m-elias/AgOpenGPS_Boards/Misc/Schematics/steer.png

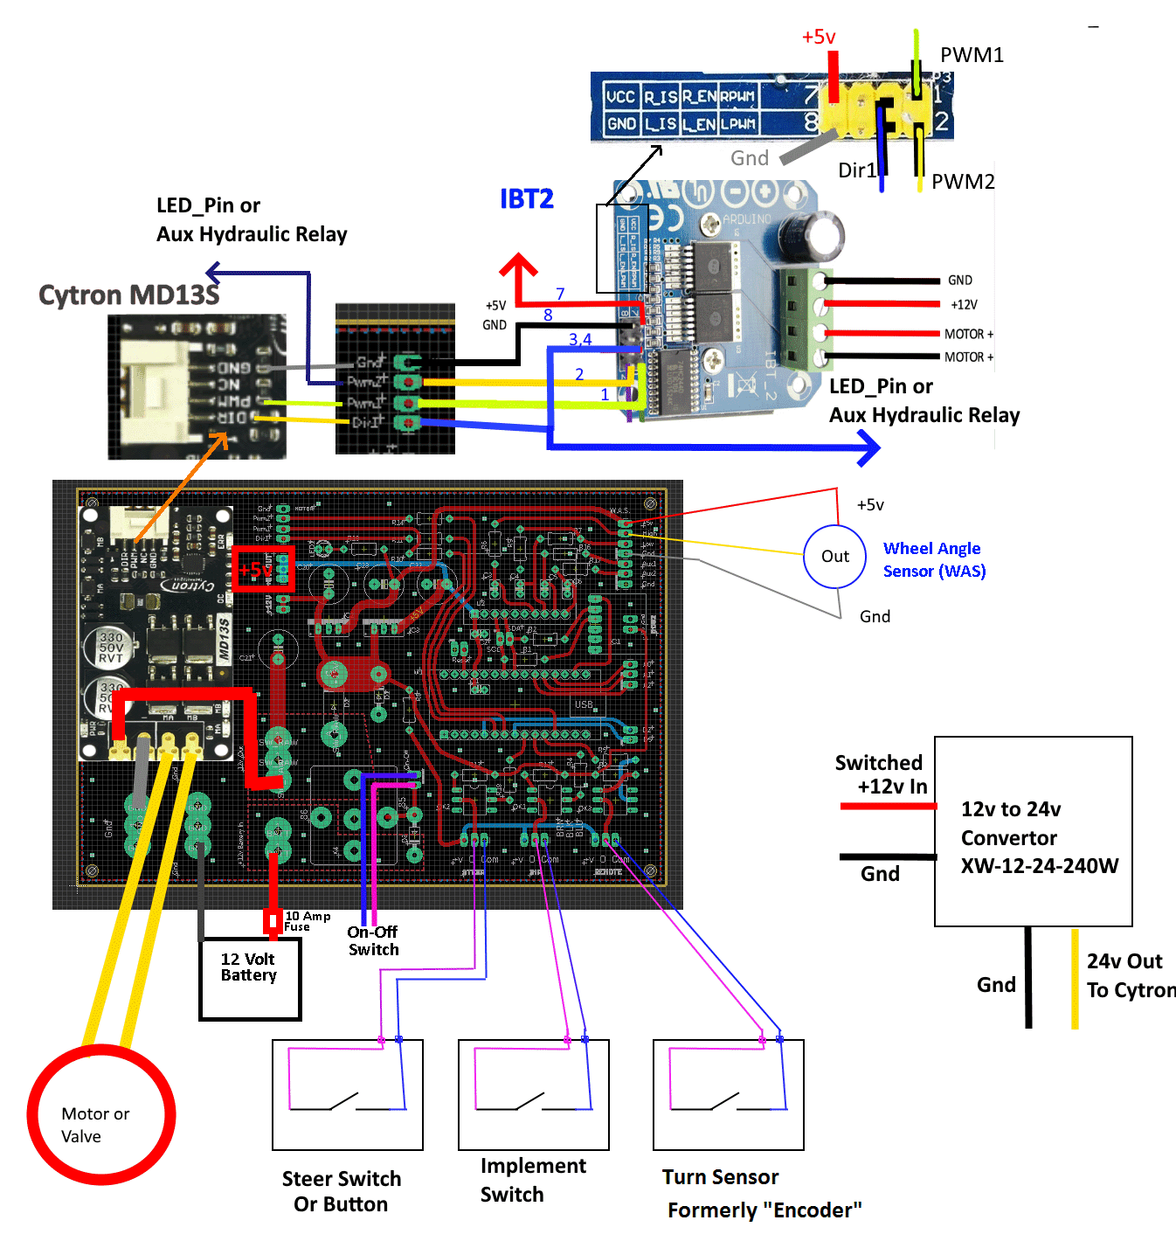
Misc/Schematics/steer.png
