m-elias/AgOpenGPS_Boards/TeensyModules/4.1 STD/MISC/3d TOP.png

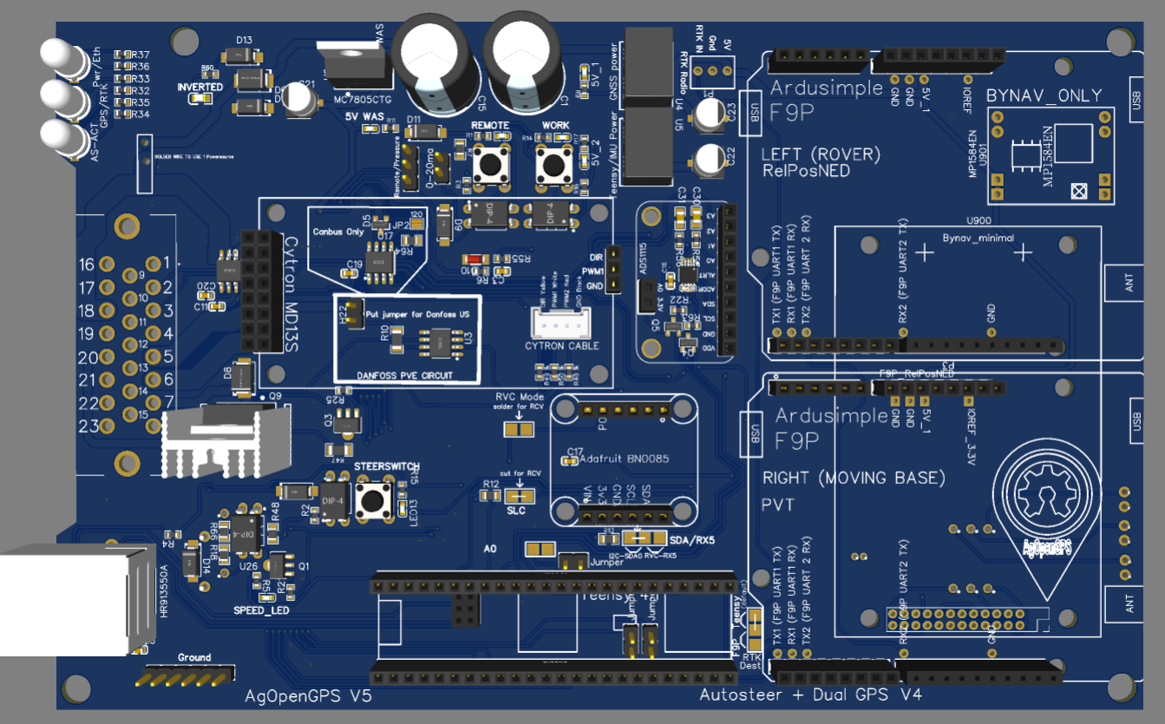
TeensyModules/4.1 STD/MISC/3d TOP.png
