m-elias/AgOpenGPS_Boards/TeensyModules/4.1 STD/Schematic_AiO V4.1 STD_RELEASE_230619/Schematic_AiO V4.1 Standard_2023-06-19_main-combined.pdf

## Power Input/Converters

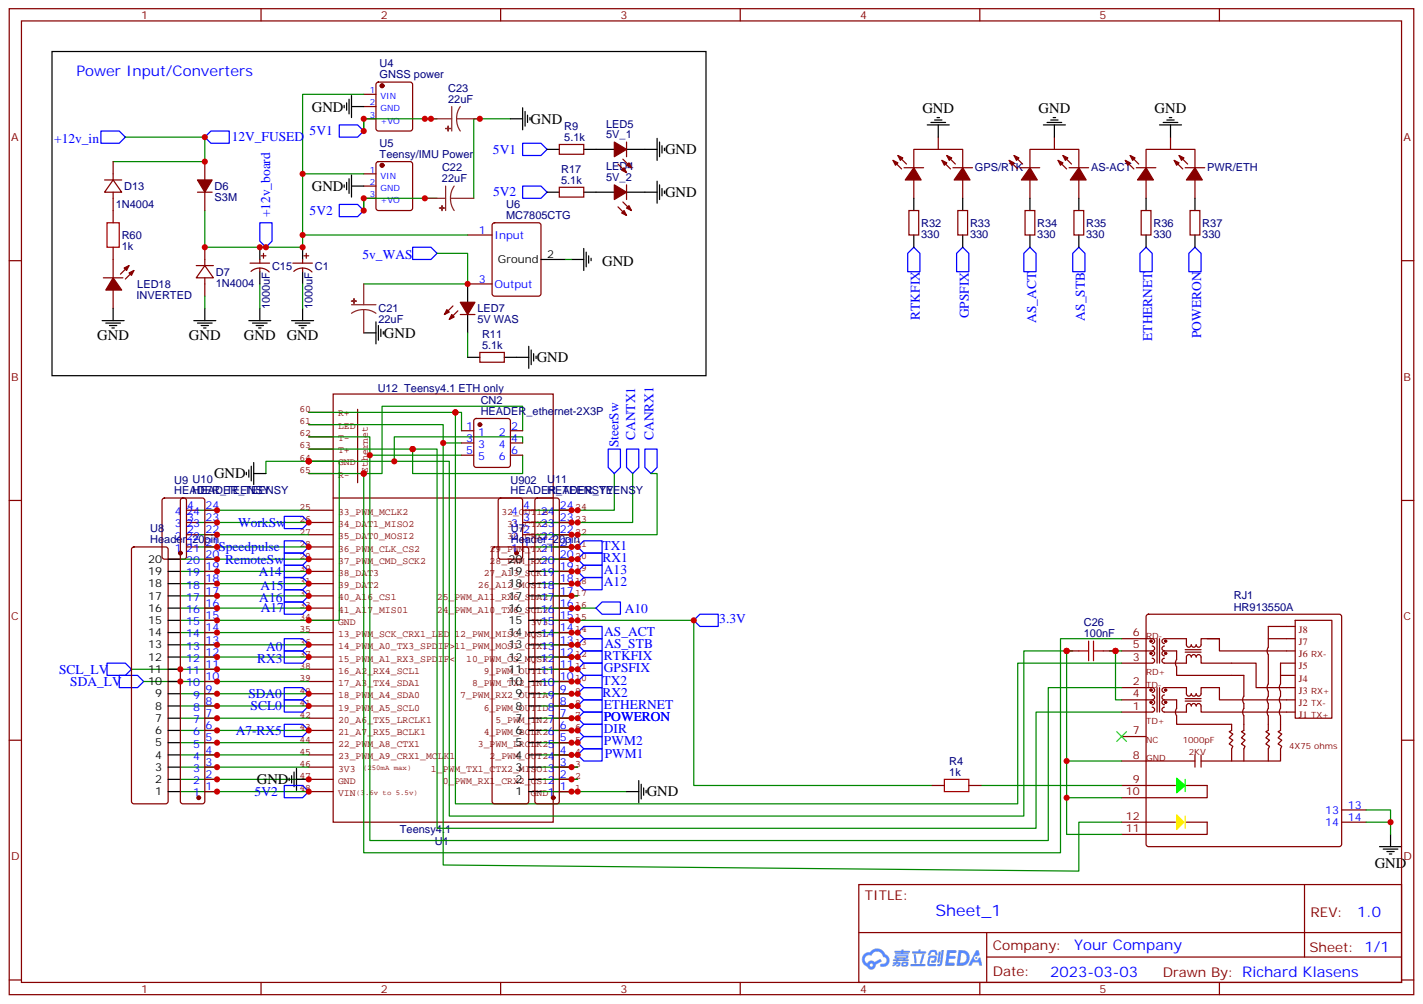
[picture p4: page 1]

Drawn By: Richard Klasens

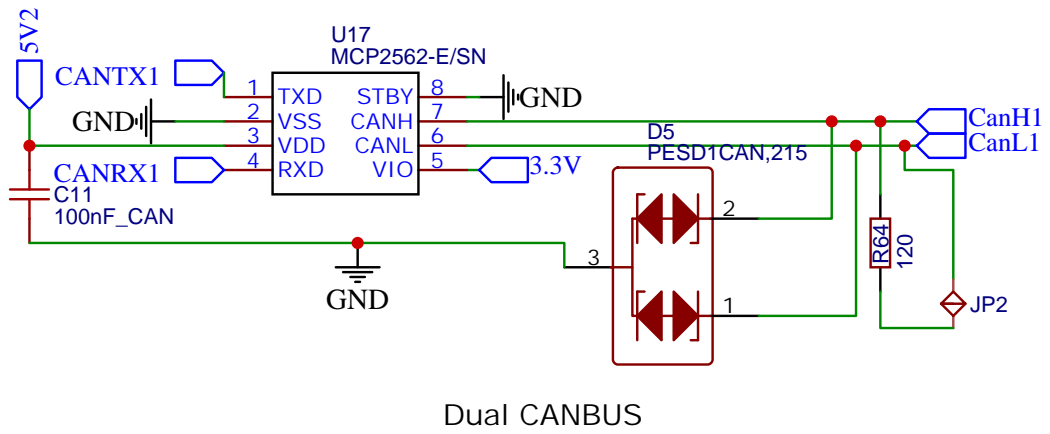
[picture p5: page 2]

## Main Connectors, just pick the one you want

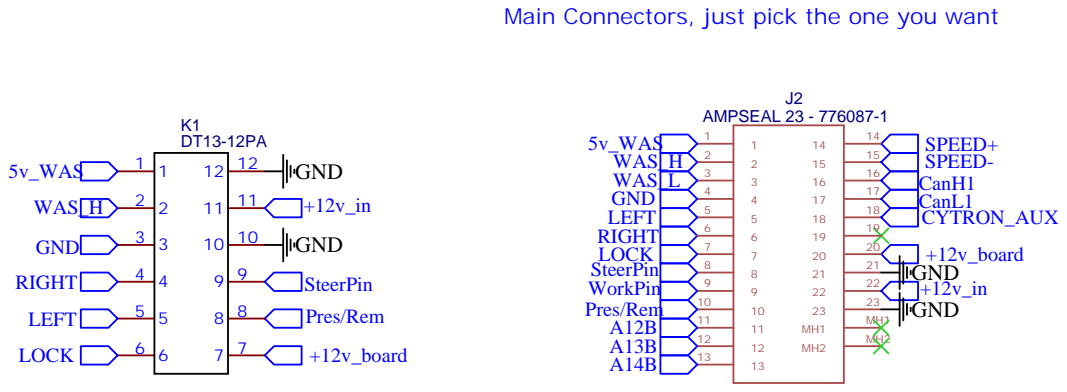
[picture p6: page 3]

# A0 19 A1 20 A2 21 A3 22 A4 23 A5 24

# Option: Bynav-C1

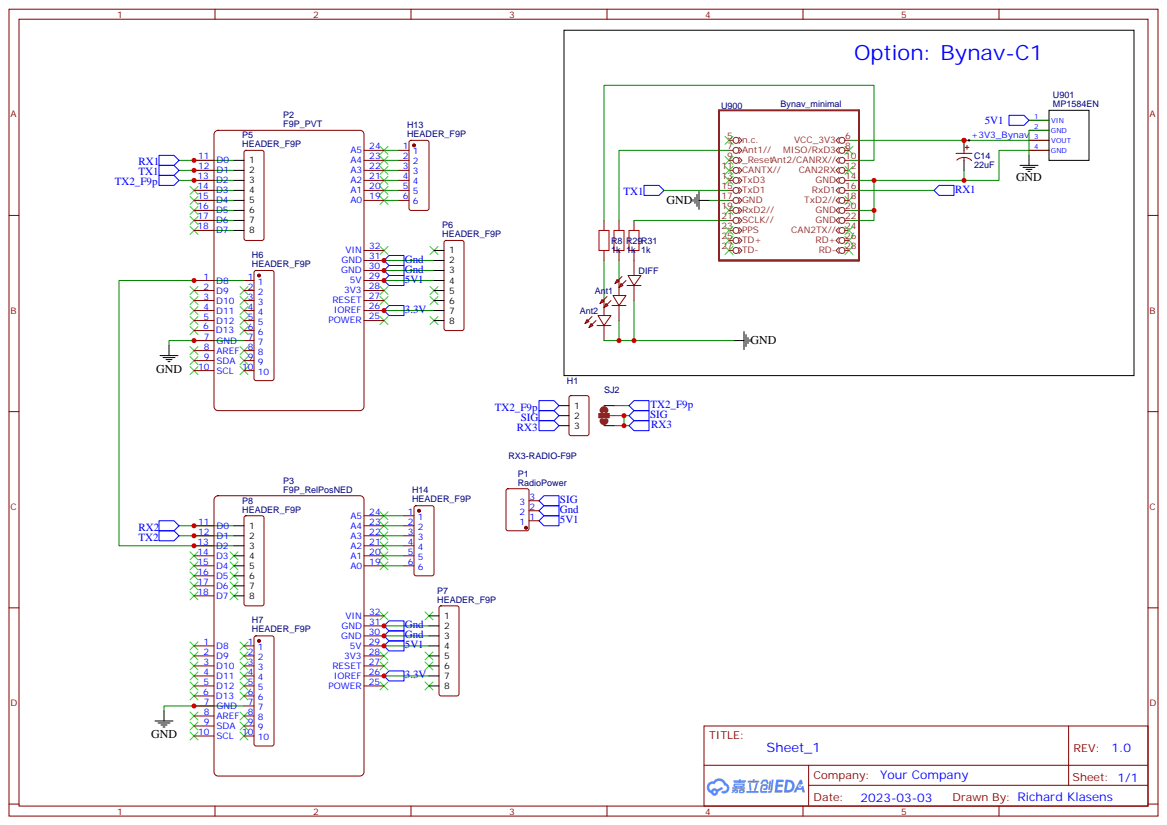
[picture p7: page 4]

POWER 25 IOREF 26 RESET 27 3V3 28 5V 29 GND 30 GND 31 VIN 32

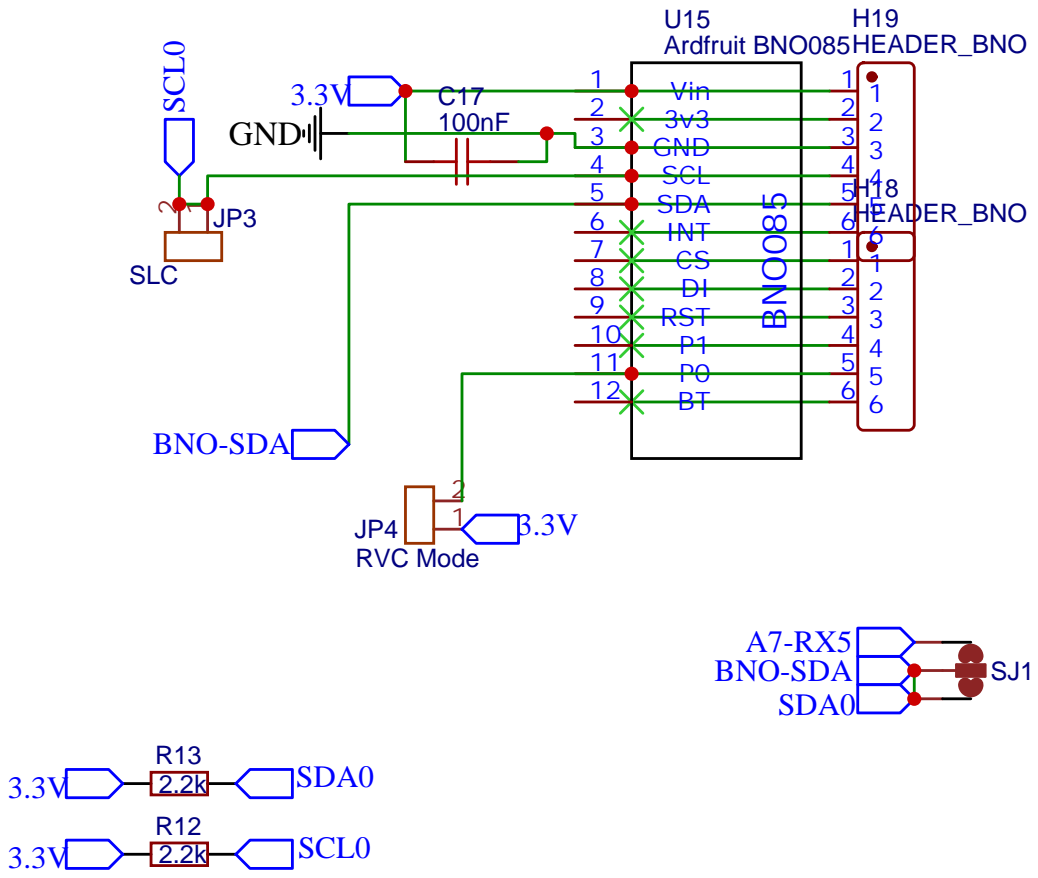
[picture p8: page 5]

## Input Switches

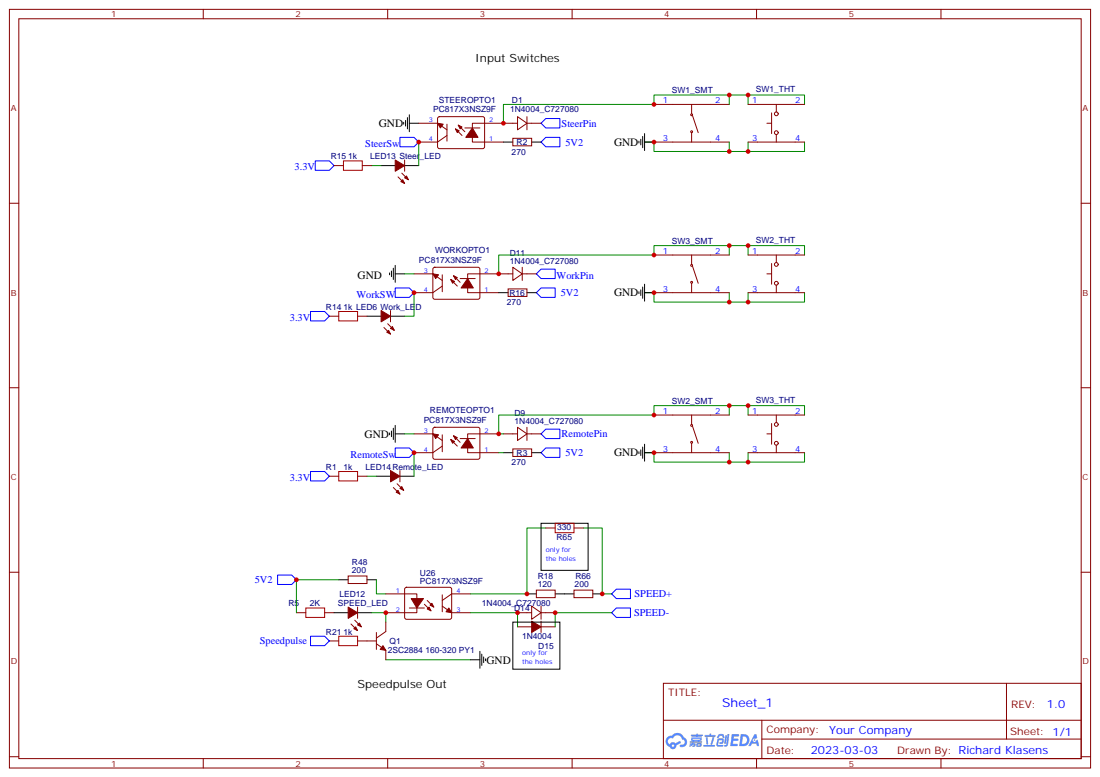
[picture p9: page 6]

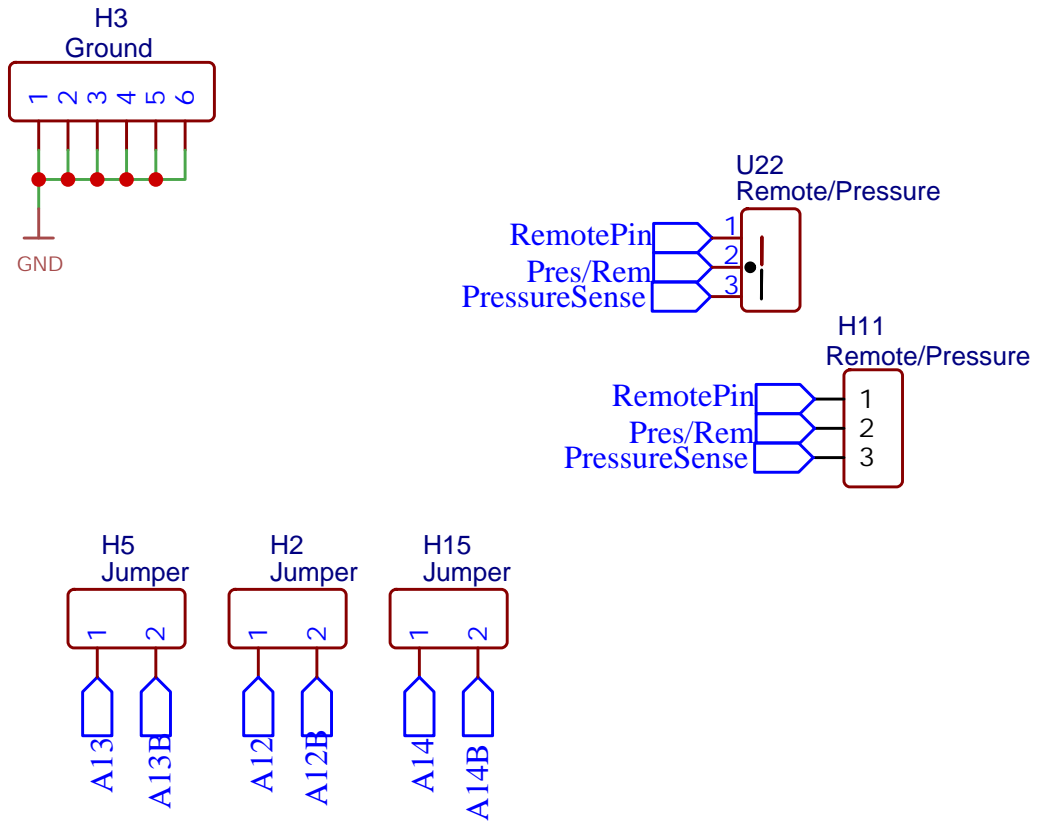
[picture p10: page 7]

## MOTOR/VALVE CONTROL

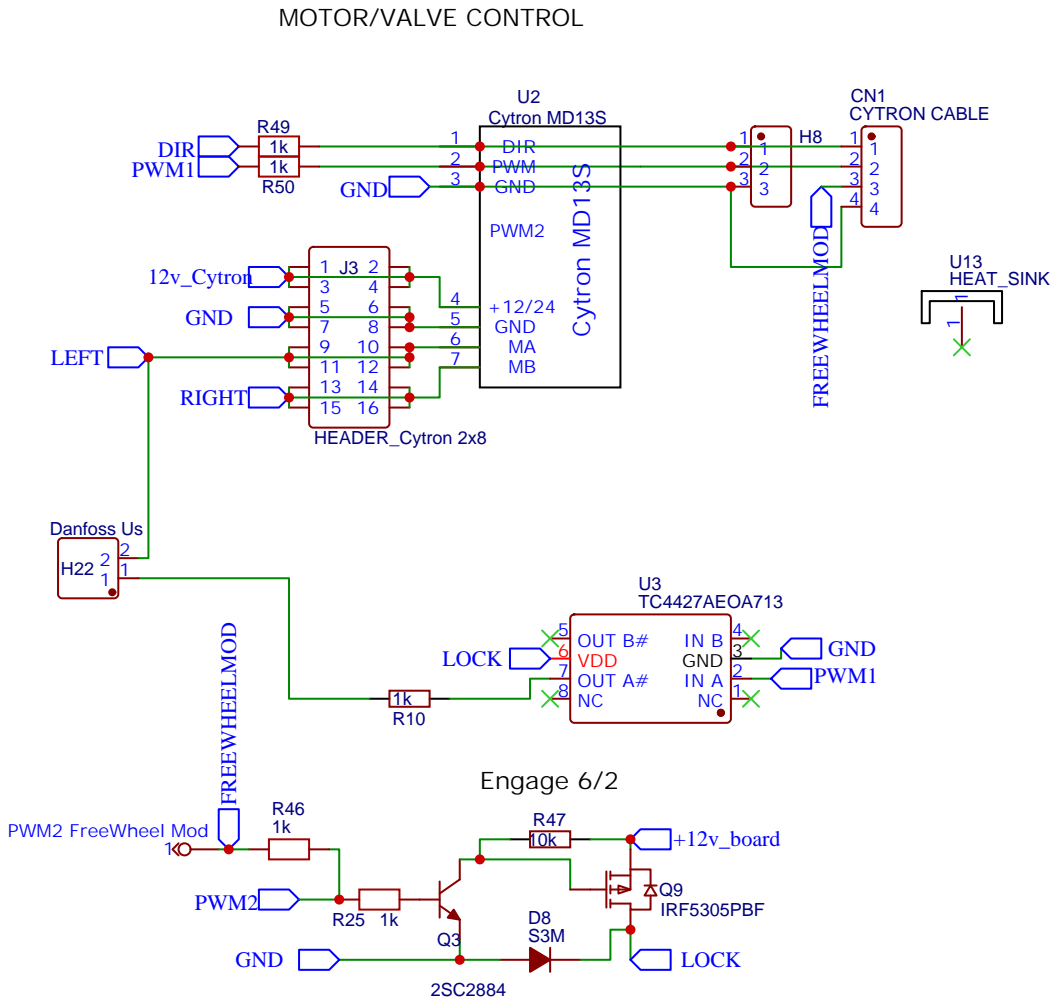
[picture p11: page 8]

## WAS Circuit for ADS - MCP6002 Teensy A/D board

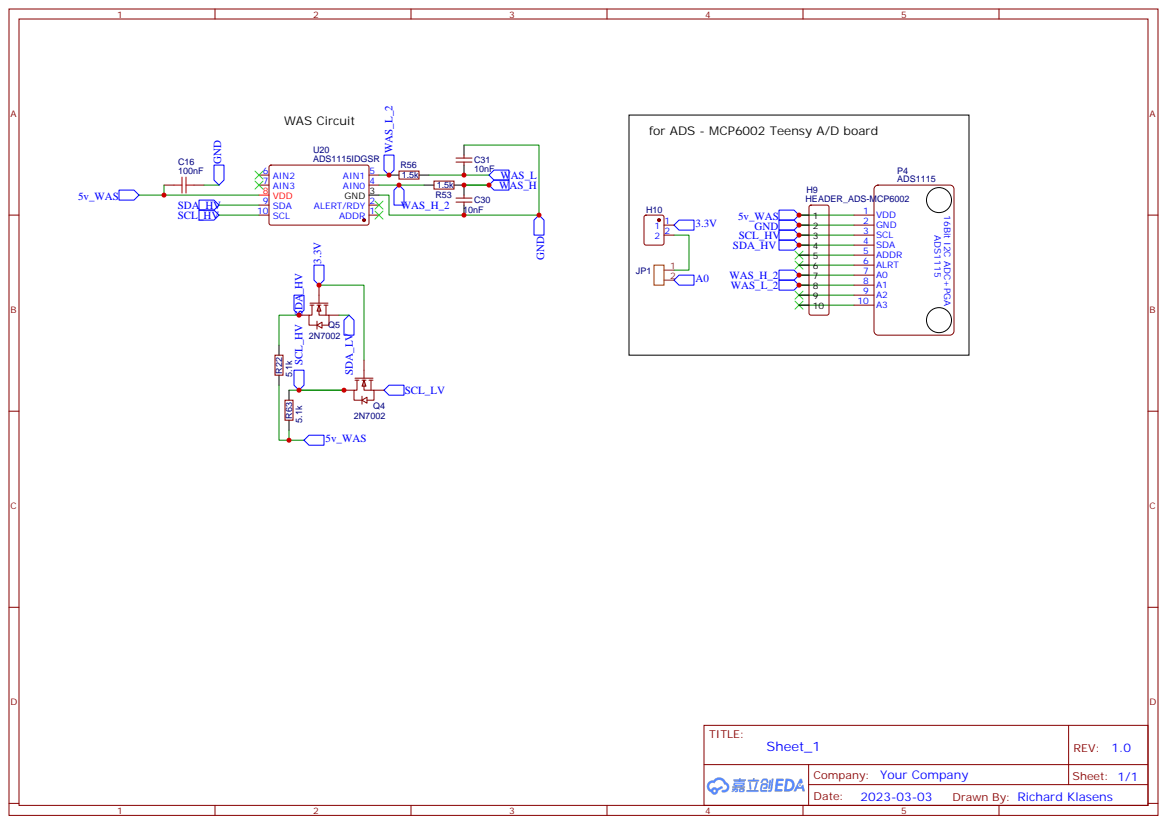
[picture p12: page 9]
