m-elias/AgOpenGPS_Boards/TeensyModules/4.1 STD/Schematic_AiO V4.1 STD_RELEASE_230619/separates/Schematic_AiO V4 Standard_2023-06-19_GPS.pdf

# A0 19 A1 20 A2 21 A3 22 A4 23 A5 24

# Option: Bynav-C1


POWER 25 IOREF 26 RESET 27 3V3 28 5V 29 GND 30 GND 31 VIN 32

Drawn By: Richard Klasens
