m-elias/AgOpenGPS_Boards/TeensyModules/4.1 STD/Schematic_AiO V4.1 STD_RELEASE_230619/separates/Schematic_AiO V4 Standard_2023-06-19_STEERING.pdf

## MOTOR/VALVE CONTROL


Drawn By: Richard Klasens
