m-elias/AgOpenGPS_Boards/TeensyModules/4.1 STD/Schematic_AiO V4.1 STD_RELEASE_230619/separates/Schematic_AiO V4 Standard_2023-06-19_WAS.pdf

## WAS Circuit for ADS - MCP6002 Teensy A/D board


Drawn By: Richard Klasens
