m-elias/AgOpenGPS_Boards/TeensyModules/V4.1/Firmware/Autosteer_gps_teensy_v4_1/JD_DAC.h

//#include "Streaming.h"
#include "MCP4728_DAC.h"
#include "zADS1115.h"
#include <Wire.h>
#include "Arduino.h"

MCP4728 dac;
ADS1115_lite dac_ads(ADS1115_ADDRESS_ADDR_VDD); // addr line pulled to VDD (0x49) ADS1115_ADDRESS_ADDR_VDD

class JD_DAC
{
public:
	JD_DAC(TwoWire& _wirePort, uint8_t _dacAddr = 0x64, uint8_t _dacSetCenterIO = 14, uint8_t _dacPrintIO = 13, Stream* _stream = NULL)
	{
		i2cPort = &_wirePort;
		dacAddr = _dacAddr;
		stream = _stream;
		dacSetCenterIO = _dacSetCenterIO;
		dacDevBtn = _dacPrintIO;
		pinMode(dacSetCenterIO, INPUT_PULLUP);
		pinMode(dacDevBtn, INPUT_PULLUP);

	}

	uint8_t steerOutput(int16_t _pwmDrive) {	// pwmDrive +-(minPWM - Max Limit)
		if (steerOutputEnabled) {
			output = map(_pwmDrive, 0, 254, 2047, 3554);		// 0/2047 is center, 254/3554 is one extreme
			outputInvt = map(_pwmDrive, 0, 254, 2047, 542);		// 0/2047 is center, 254/542 is the other extreme
			/*debugPrint("\r\n_pwmDrive: ");
			debugPrint(_pwmDrive);
			debugPrint(" -> ");
			debugPrint(output);
			debugPrint(" -> ");
			debugPrint(outputInvt);*/
			//dac.analogWrite(0, output);
			//dac.analogWrite(1, output);
			//dac.analogWrite(MCP4728::DAC_CH::C, outputInvt);
			//dac.analogWrite(MCP4728::DAC_CH::D, outputInvt); // ch D may get used for remote hyd
			dac.analogWrite(output, output, outputInvt);	// set all 3 channels, then do single i2c write loop

      return output / 16;
    }
   return 128;
  }

	void ch4Output() {
		if (ch4Enabled) {
			if (millis() > sweepTriggerTime) {
				sweep += 1;
				if (sweep > 4090) sweep = 0;
				dac.analogWrite(3, sweep, MCP4728::PWR_DOWN::NORMAL);
				sweepTriggerTime += 20;
				if (millis() > sweepTriggerTime) sweepTriggerTime = millis() + 50;
			}
		}
	}

	void steerEnable(bool _enable) {
    if (ready){
  		if (_enable != steerOutputEnabled) {
  			if (_enable) {
  				debugPrint("\r\nDAC output enabled");
  			}
  			else
  			{
  				dac.selectPowerDown(DEFAULT_PWR_DOWN, DEFAULT_PWR_DOWN, DEFAULT_PWR_DOWN, MCP4728::PWR_DOWN(dac.getPowerDown(3)));
  				debugPrint("\r\nDAC output disabled");
  			}
  			steerOutputEnabled = _enable;
  		}
		}
	}

	void loop(){

    if (!ready && initRetryTimer > 2000){
      initRetryTimer = 0;
      Serial.println("\nAttempting JD DAC init");
      if (init()){
        Serial.println("-JD DAC init successful");
      } else {
        Serial.println("-JD DAC init failed");
      }
    } else {
      if (updateAdsReadings()) {
        if (printSWS) printSWSdata();
        //Serial.println("ads update");
      }
      ch4Output();
    }
  

		if (digitalRead(dacSetCenterIO) == LOW) {
			while (digitalRead(dacSetCenterIO) == LOW) delay(5);
			/*byte i = NUM_SWS;
			debugPrint("\r\n");
			while (i--) {
				*(steeringWheelSensorCenter + i) = *(steeringWheelSensor + i);
				debugPrint(steeringWheelSensorCenter[i]); debugPrint(" ");
			}*/

      printStatus();
      printSWS = !printSWS;
		}

		if (digitalRead(dacDevBtn) == LOW) {
			while (digitalRead(dacDevBtn) == LOW) delay(5);

			if (ch4Enabled) {
				ch4Enabled = false;
				dac.analogWrite(3, sweep, MCP4728::PWR_DOWN::GND_500KOHM);
				debugPrint("\r\nch4 output disabled");
			} else {
				ch4Enabled = true;
				debugPrint("\r\nch4 output enabled");
			}
			
		}


	}

	bool updateAdsReadings(){
		// 32-33 ms per channel @ 32SPS, 96-97 ms to update 3 analog channels
		// 9-10 ms per channel @ 128SPS, 36-37 ms to update 4 analog channels
		if (dac_ads.isConversionDone()) {	// isConvDone only takes a split second to return false so hammer away
			currentAdsUpdateTime = millis();
			//debugPrint("\r\n"); debugPrint(currentAdsUpdateTime); debugPrint(" "); debugPrint(currentAdsUpdateTime - lastAdsUpdateTime);
			lastAdsUpdateTime = currentAdsUpdateTime;

			steeringWheelSensor[adsIndex] = dac_ads.getConversion();// +adsOffset[adsIndex];
			if (steeringWheelSensor[adsIndex] > 60000) steeringWheelSensor[adsIndex] = 0;

			if (adsIndex == NUM_SWS - 1) {
				dac_ads.setMux(ADS1115_REG_CONFIG_MUX_SINGLE_0);
			}
			else if (adsIndex == 0) {
				dac_ads.setMux(ADS1115_REG_CONFIG_MUX_SINGLE_1);
			}
			else if (adsIndex == 1) {
				dac_ads.setMux(ADS1115_REG_CONFIG_MUX_SINGLE_2);
			}
			else if (adsIndex == 2) {
				dac_ads.setMux(ADS1115_REG_CONFIG_MUX_SINGLE_3);
			}
			dac_ads.triggerConversion();

			adsIndex++;
			if (adsIndex == NUM_SWS) {
				//printSWSdata();
				adsIndex = 0;
				return true;
			}
		}

		return false;
	}

	void printSWSdata() {
		currentPrintTime = millis();
		//debugPrint("\r\n-ads update cycle complete");
		if (currentPrintTime > lastPrintTime + 1000)
		{
			debugPrint("\r\n"); debugPrint(currentPrintTime); debugPrint("ms ("); debugPrint(currentPrintTime - lastPrintTime); debugPrint(") ");
			for (byte n = 0; n < NUM_SWS; n++) {
				debugPrint(" ");
				/*debugPrint(n); debugPrint(": ");*/
				if (steeringWheelSensor[n] < 10000) debugPrint(" ");
				if (steeringWheelSensor[n] < 1000) debugPrint(" ");
				if (steeringWheelSensor[n] < 100) debugPrint(" ");
				if (steeringWheelSensor[n] < 10) debugPrint(" ");
				debugPrint(steeringWheelSensor[n]);
			}
			lastPrintTime += 1000;
			if (currentPrintTime > lastPrintTime) lastPrintTime = currentPrintTime + 1000;
		}
		//lastPrintTime = currentPrintTime;
	}

	bool init() {
    ready = false;
		debugPrint("-checking for Adafruit MCP4728 @ addr 0x");
		//stream->print("-checking for Adafruit MCP4728 @ addr 0x");
		debugPrint(dacAddr, HEX);
		dac.setAddr(dacAddr);
		dac.attach(*i2cPort);
		i2cPort->beginTransmission(dacAddr);
		uint8_t error = i2cPort->endTransmission();
		if (error) {
			debugPrint("\r\n--error: ");
			debugPrint(error);
			debugPrint("\r\n");
			return false;
		}
		debugPrint("\r\n--MCP4728 found!");
		debugPrint("\r\n--MCP pre init\r\n");
		printStatus();

		// set live modes, Live modes are loaded from EE right after saving to EE below but only if EE is updated
		dac.selectVref(MCP4728::VREF::VDD, MCP4728::VREF::VDD, MCP4728::VREF::VDD, MCP4728::VREF::VDD);
		dac.selectPowerDown(DEFAULT_PWR_DOWN, DEFAULT_PWR_DOWN, DEFAULT_PWR_DOWN, DEFAULT_PWR_DOWN);
		dac.selectGain(MCP4728::GAIN::X1, MCP4728::GAIN::X1, MCP4728::GAIN::X1, MCP4728::GAIN::X1);

		printStatus();

		// check/set EE modes
		// could use single EE write to all channel instead of multiple to save some time but after the first time, shouldn't need it again
		for (int i = 0; i < 4; ++i) {
			if (dac.getPowerDown(i, true) != 3) {  //DEFAULT_PWR_DOWN = MCP4728::PWR_DOWN::GND_500KOHM = 3
				debugPrint("\r\nSetting DAC EE["); debugPrint(i); debugPrint("]: "); debugPrint(dac.writeSingleChEepromModes(i, MCP4728::VREF::VDD, MCP4728::GAIN::X1, MCP4728::PWR_DOWN::GND_500KOHM));
				delay(50);  // necessary to wait for EE to finish as not using RDY IO
			}
		}
		printStatus();
		debugPrint("\r\n--MCP post init");

		debugPrint("\r\n-testing for JD_DAC ADS1115 @ addr 0x49 (addr line pulled to VDD)");
		if (dac_ads.testConnection()) {
			debugPrint("\r\n--DAC ADS1115 Connecton OK");
		} else {
			debugPrint("\r\n--DAC ADS1115 Connecton FAILED!\r\n");
			return false;
		}

		dac_ads.setSampleRate(ADS1115_REG_CONFIG_DR_32SPS); // 128 samples per second, default
		dac_ads.setGain(ADS1115_REG_CONFIG_PGA_6_144V);      // for 6.144V input, JD SWS don't output higher then 4.1 V but DAC can output 5V
		dac_ads.setMux(ADS1115_REG_CONFIG_MUX_SINGLE_0);	 // single ended inputs
		dac_ads.triggerConversion();
		lastAdsUpdateTime = millis();
		adsIndex = 0;
		debugPrint("\r\n");
		ready = true;
		return true;
	}

	void setDebugStream(Stream* _stream) {
		stream = _stream;
	}

	void printStatus() {
		delay(50);
		dac.readRegisters();
		delay(50);

		debugPrint("\r\nDAC#\tVref\tGain\tPD\tDACData\r\n");
		for (int i = 0; i < 4; ++i) {
			debugPrint(i, DEC);
			debugPrint("\t");

			debugPrint(dac.getVref(i), DEC);
			debugPrint("[");
			debugPrint(dac.getVref(i, true), DEC);
			debugPrint("]\t");

			debugPrint(dac.getGain(i), DEC);
			debugPrint("[");
			debugPrint(dac.getGain(i, true), DEC);
			debugPrint("]\t");

			debugPrint(dac.getPowerDown(i), DEC);
			debugPrint("[");
			debugPrint(dac.getPowerDown(i, true), DEC);
			debugPrint("]\t");

			debugPrint(dac.getDACData(i), DEC);
			debugPrint("[");
			debugPrint(dac.getDACData(i, true), DEC);
			debugPrint("]\r\n");
		}
	}

  bool printSWS = 0;

private:
	Stream* stream = NULL;
  elapsedMillis initRetryTimer = 0;
	bool ready = false;
	bool steerOutputEnabled = 0;
	bool ch4Enabled = 0;
	//uint16_t left_center_right_DAC[3] = { 3512, 2019, 501 };
	//uint16_t left_center_right_ADS[3] = { 22812, 13150, 3501 };
	//uint8_t outputIndex = 0;
	uint16_t output;
	uint16_t outputInvt;
	const static uint8_t NUM_SWS = 4;
	uint16_t steeringWheelSensor[NUM_SWS];
	uint16_t steeringWheelSensorCenter[NUM_SWS];

	TwoWire* i2cPort;
	uint8_t dacAddr;
	uint8_t dacSetCenterIO;
	uint8_t dacDevBtn;
	MCP4728::PWR_DOWN DEFAULT_PWR_DOWN = MCP4728::PWR_DOWN::GND_500KOHM;

	//const uint16_t LOOP_TIME = 25;  //40Hz    
	uint32_t lastAdsUpdateTime;
	uint32_t currentAdsUpdateTime;
	uint32_t lastPrintTime;
	uint32_t currentPrintTime;
	uint8_t adsIndex;
	//int16_t adsOffset[4] = { 425, 212, 369, 177 };
	//elapsedMillis adsTimer;
	uint16_t sweep = 0;
	uint32_t sweepTriggerTime;
	
	template<typename M>
	inline size_t debugPrint(M _message) {
		if (stream != NULL) {
			return stream->print(_message);
		}
		return false;
	}

	template<typename N>
	inline size_t debugPrint(N _number, int16_t _format) {
		if (stream != NULL) {
			return stream->print(_number, _format);
		}
		return false;
	}
};
