m-elias/AgOpenGPS_Boards/TeensyModules/V4.1/Firmware/Autosteer_gps_teensy_v4_1/MCP4728_DAC.h

// adapted/expanded from https://github.com/hideakitai/MCP4728

#pragma once
#ifndef MCP4728_H
#define MCP4728_H

#include "Arduino.h"
#include <Wire.h>

class MCP4728{
public:

    enum class CMD{
        FAST_WRITE = 0x00,
        MULTI_WRITE = 0x40,
        SINGLE_WRITE = 0x58,
        SEQ_WRITE = 0x50,
        SELECT_VREF = 0x80,
        SELECT_GAIN = 0xC0,
        SELECT_PWRDOWN = 0xA0
    };
    enum class DAC_CH { A, B, C, D };
    enum class VREF { VDD, INTERNAL_2_8V };
    enum class PWR_DOWN { NORMAL, GND_1KOHM, GND_100KOHM, GND_500KOHM };
    enum class GAIN { X1, X2 };

    void attach(TwoWire& w){ //, uint8_t pin){
        wire_ = &w;
        //pin_ldac_ = pin;
        //pinMode(pin_ldac_, OUTPUT);
        //enable(false);
        readRegisters();
        return;
    }

    //void enable(bool b){
        //digitalWrite(pin_ldac_, !b);
    //}

    uint8_t analogWrite(DAC_CH ch, uint16_t data, bool b_eep = false){
        return analogWrite((uint8_t)ch, data, b_eep);
    }

    uint8_t analogWrite(uint8_t ch, uint16_t data, PWR_DOWN pd) {
        reg_[ch].data = data;
        reg_[ch].pd = pd;
        return single_Ch_Write_to_Reg(ch);
    }

    uint8_t analogWrite(uint8_t ch, uint16_t data, bool b_eep = false){
        if (b_eep){
            eep_[ch].data = data;
            return single_Ch_Write_to_Reg_and_Ee(ch);
        } else {
            reg_[ch].data = data;
            reg_[ch].pd = PWR_DOWN::NORMAL; // have to change PD setting, otherwise it output won't change
            return all_Ch_Fast_Write_Output_and_Pd_only();
        }
    }

    uint8_t analogWrite(uint16_t a, uint16_t b, uint16_t c) {
        reg_[0].data = a;
        reg_[1].data = b;
        reg_[2].data = c;
        reg_[0].pd = PWR_DOWN::NORMAL;
        reg_[1].pd = PWR_DOWN::NORMAL;
        reg_[2].pd = PWR_DOWN::NORMAL;
        return all_Ch_Fast_Write_Output_and_Pd_only();
    }

    uint8_t analogWrite(uint16_t a, uint16_t b, uint16_t c, uint16_t d, bool b_eep = false){
        if (b_eep){
            reg_[0].data = eep_[0].data = a;
            reg_[1].data = eep_[1].data = b;
            reg_[2].data = eep_[2].data = c;
            reg_[3].data = eep_[3].data = d;
            return all_Ch_Write_to_Reg_and_Ee();
        } else {
            reg_[0].data = a;
            reg_[1].data = b;
            reg_[2].data = c;
            reg_[3].data = d;
            reg_[0].pd = PWR_DOWN::NORMAL;
            reg_[1].pd = PWR_DOWN::NORMAL;
            reg_[2].pd = PWR_DOWN::NORMAL;
            reg_[3].pd = PWR_DOWN::NORMAL;
            return all_Ch_Fast_Write_Output_and_Pd_only();
        }
    }

    uint8_t selectVref(VREF a, VREF b, VREF c, VREF d){
        reg_[0].vref = a;
        reg_[1].vref = b;
        reg_[2].vref = c;
        reg_[3].vref = d;

        uint8_t data = (uint8_t)CMD::SELECT_VREF;
        for (uint8_t i = 0; i < 4; ++i) bitWrite(data, 3 - i, (uint8_t)reg_[i].vref);

        wire_->beginTransmission(addr_);
        wire_->write(data);
        return wire_->endTransmission();
    }

    uint8_t selectPowerDown(PWR_DOWN a, PWR_DOWN b, PWR_DOWN c, PWR_DOWN d){
        reg_[0].pd = a;
        reg_[1].pd = b;
        reg_[2].pd = c;
        reg_[3].pd = d;

        uint8_t h = ((uint8_t)CMD::SELECT_PWRDOWN) | ((uint8_t)a << 2) | (uint8_t)b;
        uint8_t l = 0 | ((uint8_t)c << 6) | ((uint8_t)d << 4);

        wire_->beginTransmission(addr_);
        wire_->write(h);
        wire_->write(l);
        return wire_->endTransmission();
    }

    uint8_t selectGain(GAIN a, GAIN b, GAIN c, GAIN d){
        reg_[0].gain = a;
        reg_[1].gain = b;
        reg_[2].gain = c;
        reg_[3].gain = d;

        uint8_t data = (uint8_t)CMD::SELECT_GAIN;
        for (uint8_t i = 0; i < 4; ++i) bitWrite(data, 3 - i, (uint8_t)reg_[i].gain);

        wire_->beginTransmission(addr_);
        wire_->write(data);
        return wire_->endTransmission();
    }

    void setID(uint8_t id) { addr_ = I2C_ADDR + id; }

    void setAddr(uint8_t addr) { addr_ = addr; }

    void readRegisters(){
        wire_->requestFrom((int)addr_, 24);
        if (wire_->available() == 24){
            for (uint8_t i = 0; i < 8; ++i){
                uint8_t data[3];
                bool isEeprom = i % 2;
                for (uint8_t i = 0; i < 3; ++i) data[i] = wire_->read();

                uint8_t ch = (data[0] & 0x30) >> 4;
                if (isEeprom){
                    /*read_eep_[ch].vref = (VREF)    ((data[1] & 0b10000000) >> 7);
                    read_eep_[ch].pd   = (PWR_DOWN)((data[1] & 0b01100000) >> 5);
                    read_eep_[ch].gain = (GAIN)    ((data[1] & 0b00010000) >> 4);
                    read_eep_[ch].data = (uint16_t)((data[1] & 0b00001111) << 8 | data[2]);*/
                    eep_[ch].vref = (VREF)    ((data[1] & 0b10000000) >> 7);
                    eep_[ch].pd   = (PWR_DOWN)((data[1] & 0b01100000) >> 5);
                    eep_[ch].gain = (GAIN)    ((data[1] & 0b00010000) >> 4);
                    eep_[ch].data = (uint16_t)((data[1] & 0b00001111) << 8 | data[2]);
                } else {
                    /*read_reg_[ch].vref = (VREF)    ((data[1] & 0b10000000) >> 7);
                    read_reg_[ch].pd   = (PWR_DOWN)((data[1] & 0b01100000) >> 5);
                    read_reg_[ch].gain = (GAIN)    ((data[1] & 0b00010000) >> 4);
                    read_reg_[ch].data = (uint16_t)((data[1] & 0b00001111) << 8 | data[2]);*/
                    reg_[ch].vref = (VREF)    ((data[1] & 0b10000000) >> 7);
                    reg_[ch].pd   = (PWR_DOWN)((data[1] & 0b01100000) >> 5);
                    reg_[ch].gain = (GAIN)    ((data[1] & 0b00010000) >> 4);
                    reg_[ch].data = (uint16_t)((data[1] & 0b00001111) << 8 | data[2]);
                }
            }
        }
    }

    uint8_t writeSingleChEepromModes(uint8_t ch, VREF a, GAIN b, PWR_DOWN c){
      eep_[ch].vref = a;
      eep_[ch].gain = b;
      eep_[ch].pd = c;
      return single_Ch_Write_to_Reg_and_Ee(ch);
    }

    //uint8_t getReadVref(uint8_t ch, bool b_eep = false) { return b_eep ? (uint8_t)read_eep_[ch].vref : (uint8_t)read_reg_[ch].vref; }
    //uint8_t getReadGain(uint8_t ch, bool b_eep = false) { return b_eep ? (uint8_t)read_eep_[ch].gain: (uint8_t)read_reg_[ch].gain; }
    //uint8_t getReadPowerDown(uint8_t ch, bool b_eep = false) { return b_eep ? (uint8_t)read_eep_[ch].pd : (uint8_t)read_reg_[ch].pd; }
    //uint16_t getReadDACData(uint8_t ch, bool b_eep = false) { return b_eep ? (uint16_t)read_eep_[ch].data : (uint16_t)read_reg_[ch].data; }

    uint8_t getVref(uint8_t ch, bool b_eep = false) { return b_eep ? (uint8_t)eep_[ch].vref : (uint8_t)reg_[ch].vref; }
    uint8_t getGain(uint8_t ch, bool b_eep = false) { return b_eep ? (uint8_t)eep_[ch].gain: (uint8_t)reg_[ch].gain; }
    uint8_t getPowerDown(uint8_t ch, bool b_eep = false) { return b_eep ? (uint8_t)eep_[ch].pd : (uint8_t)reg_[ch].pd; }
    uint16_t getDACData(uint8_t ch, bool b_eep = false) { return b_eep ? (uint16_t)eep_[ch].data : (uint16_t)reg_[ch].data; }

private:

    uint8_t all_Ch_Fast_Write_Output_and_Pd_only(){   // write output data only to all channels
        wire_->beginTransmission(addr_);
        for (uint8_t i = 0; i < 4; ++i){
            wire_->write((uint8_t)CMD::FAST_WRITE | ((uint8_t)reg_[i].pd << 4) | highByte(reg_[i].data));   // include PD to turn on only desired channels
            //wire_->write((uint8_t)CMD::FAST_WRITE | highByte(reg_[i].data));  // can write output (.data) only too
            wire_->write(lowByte(reg_[i].data));
            
        }
        return wire_->endTransmission();
    }

    uint8_t single_Ch_Write_to_Reg(uint8_t ch) {    // write all data to a single channel
        wire_->beginTransmission(addr_);
        //for (uint8_t i = 0; i < 4; ++i){
            wire_->write((uint8_t)CMD::MULTI_WRITE | (ch << 1));
            wire_->write(((uint8_t)reg_[ch].vref << 7) | ((uint8_t)reg_[ch].pd << 5) | ((uint8_t)reg_[ch].gain << 4) | highByte(reg_[ch].data));
            wire_->write(lowByte(reg_[ch].data));
        //}
        return wire_->endTransmission();
    }

    uint8_t all_Ch_Write_to_Reg_and_Ee(){  // write all EE data to register and eeprom for all channels
        wire_->beginTransmission(addr_);
        wire_->write((uint8_t)CMD::SEQ_WRITE);
        for (uint8_t i = 0; i < 4; ++i){
            wire_->write(((uint8_t)eep_[i].vref << 7) | ((uint8_t)eep_[i].pd << 5) | ((uint8_t)eep_[i].gain << 4) | highByte(eep_[i].data));
            wire_->write(lowByte(eep_[i].data));
        }
        uint8_t reply = wire_->endTransmission();
        delay(50);  // or use RDY/BSY input from MCP4728, min 50ms wait for EE to finish
        return reply;
    }

    uint8_t single_Ch_Write_to_Reg_and_Ee(uint8_t ch){ // write all EE data to register and eeprom for a single channel
        wire_->beginTransmission(addr_);
        wire_->write((uint8_t)CMD::SINGLE_WRITE | (ch << 1));
        wire_->write(((uint8_t)eep_[ch].vref << 7) | ((uint8_t)eep_[ch].pd << 5) | ((uint8_t)eep_[ch].gain << 4) | highByte(eep_[ch].data));
        wire_->write(lowByte(eep_[ch].data));
        uint8_t reply = wire_->endTransmission();
        delay(50);  // or use RDY/BSY input from MCP4728, min 50ms wait for EE to finish
        return reply;
    }

private:

    struct DACInputData{
        VREF vref;
        PWR_DOWN pd;
        GAIN gain;
        uint16_t data;
    };

    const uint8_t I2C_ADDR {0x60};

    uint8_t addr_ {I2C_ADDR};
    //uint8_t pin_ldac_;

    DACInputData reg_[4];
    DACInputData eep_[4];
    //DACInputData read_reg_[4];
    //DACInputData read_eep_[4];

    TwoWire* wire_;
};

#endif // MCP4728_H
