m-elias/AgOpenGPS_Boards/TeensyModules/V4.1/Firmware/Autosteer_gps_teensy_v4_1/io.h

/*
Pat's v1.0.0 Micro
  wire0/BNO not used
  wire1/ADS could be used but not needed with A0/WAS input

  A0 WAS input
  A4 section4 input
  A5 section3 input
  A10 Pressure input
  A11 section5 input
  A13 section1 input
  A16 section2 input
  
  


 */
