m-elias/AgOpenGPS_Boards/(commit log)

2023-05-04 Added reset, JD_DAC & corrected NMEA
    Manually merged reset.h, JD_DAC.h & corrected NMEA output code to latest official 4.1
    [Autosteer.ino, AutosteerPID.ino, Autosteer_gps_teensy_v4_1.ino, JD_DAC.h, MCP4728_DAC.h, reset.h, zHandlers.ino]
2023-05-05 Correct NMEA fixes, other tweaks
    After testing in tractor, Corrected NMEA code wasn't completely merged, organized JD_DAC code differently.
    [Autosteer.ino, Autosteer_gps_teensy_v4_1.ino, JD_DAC.h, zHandlers.ino]
2023-05-30 Tweaked for RoGator
    Removed I2C ADS, set baudRTK for 460800
2023-12-15 new steer switch lockout
    To lockout Steer "Switch" when current/pressure kicks out autosteer until the switch is cycled.
2024-01-24 remove wire1 calls that fail
    Removed Wire1.end/begin calls that cause Teensy boot loops with Teensyduino 1.58
    [zADS1115.cpp]
2024-01-25 ads wire/i2c fix
